henewi/alx-board/faceplate/alx-faceplate.dxf

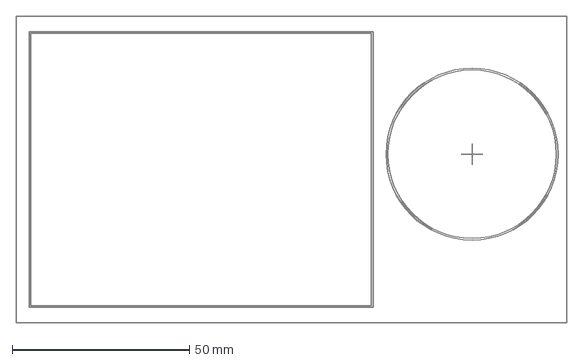
[picture p26: CAD file, 2026-11-02]
faceplate/alx-faceplate.dxf
155.1 x 86.4 mm
