henewi/alx-board/(commit log)

2026-10-27 ALX Departures v1.0: desk flight board for Alex
    Solari-style departure board and radar of the aircraft overhead, for a
    Raspberry Pi 4 with a 7" 1024x600 screen. Python standard library only.
    - Live flights (adsb.lol, adsb.fi), routes, photos, weather, ISS passes
    - 11 board styles, all with the same layout for the faceplate
    - Wi-Fi setup hotspot with required postcode, phone settings page
    - Watchdogs, silent nightly restart, remote updates with rollback
    Claude-Session: https://claude.ai/code/session_01E5QaWKAHDSNzw7Z97BbJV6
2026-10-27 v1.1: fill in more routes, check them, and show the right range
    - Second route database (hexdb.io) when adsbdb doesn't know a flight
    - Ignore routes that don't fit where the plane is (reused callsigns)
    - Low planes climbing out of / descending into a nearby airport show
    "DEPARTED LUTON" / "ARRIVING LUTON" (OurAirports list, public domain)
    - "Nothing within N miles" follows the radar range setting
    - Updates come from henewi/alx-board by default
    - Self-test checks both route databases
    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
2026-10-27 Back off politely from flight feeds that refuse or time out
    A feed that rate-limits (429), refuses or times out now rests for
    longer each time in a row (1, 2, 4, 8 … minutes, up to 30), and resets
    once it answers again. The board settles on whichever feed is healthy
    instead of retrying a busy one every minute, and waits at most 6 s for
    a slow feed before trying the next.
    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
2026-10-27 Remove edges around the board window and hide the map credit
    - Ivory, Cockpit and Racing Green no longer draw a frame inside the
    board window; Graphite's red edge bar and Wavepunk's top neon line
    are gone, Graphite's speed stripes sit inside the window, and
    Wavepunk's header/footer glow is a line rather than a box
    - Map credit hidden (private display); credits kept in the README
    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
2026-11-01 Updater only moves forward
    Compare release numbers instead of just checking they differ, so a
    board running a newer version than the latest published release is
    never "updated" backwards.
    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
2026-11-02 Quieter start-up: no bootloader screen, no warning icons, no white flash
    - install.sh turns off the bootloader's diagnostics screen
    (DISABLE_HDMI=1) and the Pi's on-screen warning icons
    - The board page paints black first, so the browser never flashes white
    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
2026-11-02 Less work for the Pi: cheaper radar animations
    - Planes step to their new position each second instead of gliding
    (they move 1-2 px a second; the glide redrew the whole SVG radar
    60 times a second)
    - Radar sweep at 20 frames a second on its own layer
    - Always-on pulses (home marker, live dot, alerts, ISS) in gentle steps
    Measured with software drawing: the browser's total CPU fell from 35%
    to 15% of one core, with no visible change to the board.
    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
2026-11-02 Round radar on the real panel, and faceplate cut files
    - The 7" panel's pixels aren't square (155.1 mm / 1024 px across,
    86.4 mm / 600 px down), so on the Pi the radar is stretched 5.18%
    taller: a true 48.47 mm circle on the glass, same centre
    - faceplate/: 1:1 cut-outs as DXF (mm) and SVG, a printable A4 PDF
    template with a 50 mm scale check, and the numbers in cutouts.txt.
    Cut lines sit 0.5 mm inside the image edge to hide alignment error.
    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
    [alx-faceplate.dxf]
2026-11-03 Update README with credits and mounting details
    Added credits and details about the unit's mounting and finishing.
2026-11-04 Style button on the frame (no touch screen needed)
    A push button between GPIO17 (pin 11) and GND (pin 9) becomes an Enter
    key via the gpio-key overlay (added by install.sh). First press opens
    the style picker with the phone QR code; each press after that moves to
    the next style. Any keyboard's Enter key does the same.
    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
2026-11-04 Remove the style button
    Henry doesn't want a button on the frame: take out the Enter-key
    handler, the gpio-key line in install.sh and the README notes.
    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
2026-11-04 Footer shows the phone settings address
    Without a touch screen, the footer's rotating messages now include
    "SETTINGS: <board address>:8080/settings" so Alex can find her phone
    page for style, range and postcode.
    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
2026-11-08 README: build section with photos
    New "The build" section: Henry's mount and finishing notes, with five
    photos in order: 3D scans in the wooden body, CAD rear view with the
    carbon plate, the printed Pi and screen mount, printing the wood
    cutting template, and the template with the mount.
    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
2026-11-10 Invisible mouse pointer on the board
    The screen's USB lead can register as a pointing device, so the kiosk
    showed a pointer in the middle of the screen until it was moved. The
    installer now writes a fully transparent pointer theme
    (pi/blank_cursor.py) and the screen service uses it, so no pointer is
    ever drawn, from start-up onwards.
    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
2026-11-10 Fine-tune the radar to the porthole in mm
    "radar_adjust_mm": {"top": .., "bottom": ..} in config.json grows the
    radar's top and/or bottom by that many millimetres on the glass, on top
    of the pixel_aspect circle correction.
    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
2026-11-10 Rename to HOWE INTERNATIONAL
    Board header, start-up boarding pass, Wi-Fi setup and postcode screens,
    phone settings page and Wi-Fi setup page now say HOWE INTERNATIONAL.
    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
2026-11-11 Version v1.4
    VERSION had stayed at v1.1 while releases went up to v1.3, so a board
    installed from main (labelled v1.1) "updated" overnight to the older
    v1.3 release. Label main as v1.4 so it can be released, and note in
    UPDATES.md that VERSION must match the release tag.
    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
2026-11-13 v1.5: sign-in that can't be skipped, Pi lights off, six new styles
    - Wi-Fi: never shows an empty board. A "looking for Wi-Fi" screen with a
    countdown appears whenever it's offline. Setup opens after ~40 s when no
    saved network is in range (was 3 minutes, while the board showed blank
    after 45 s). Networks that want a sign-in page are explained instead of
    blamed on the password. Setup network restarts itself if it drops; retries
    wait while someone is using the setup page.
    - Pi's red and green lights turned off by the service at start and in
    config.txt, so they don't glow through the faceplate.
    - Styles: Racing Green, Jet Age and Graphite retired (saved ones move to
    Sage, Dusk, So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
2026-11-13 v1.7: Cosmos, Grand Prix and Pho styles; Ivory retired
    - Cosmos: starfield and nebulae, a constellation, Michroma lettering,
    and an orrery radar with planets on dashed orbits
    - Grand Prix: pit-wall timing colours, kerbs, sector bar, chequered flag
    and a soft-tyre radar (generic, no team or series logos)
    - Pho: red lacquer and gold signage, lanterns, enamel menu tiles, and the
    radar is a bowl of pho in a blue-and-white bowl
    - Ivory removed; a saved Ivory moves to Renaissance
    - New fonts (SIL OFL): Michroma, Lilita One. Layout identical across all 20
    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
2026-11-13 README: lead with the build story and features, technical details at the end
    Adds 19 build photos to docs/build (milling the body through to the finished board).
    Claude-Session: https://claude.ai/code/session_01WDqVkSWpbUVQNxsRyTD4p8
2026-11-13 README: heat-set inserts photo, renamed so it isn't served from cache
    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
